tennessee-garage/tasty-totems/README.md

# tasty-totems
Repo for a zoetrope type of art project
