tennessee-garage/tasty-totems/pcb/tasty-totem-board-mux/tasty-totem-board.kicad_pcb

## KiCad design pcb/tasty-totem-board-mux/tasty-totem-board.kicad_pcb (2024-07-24)

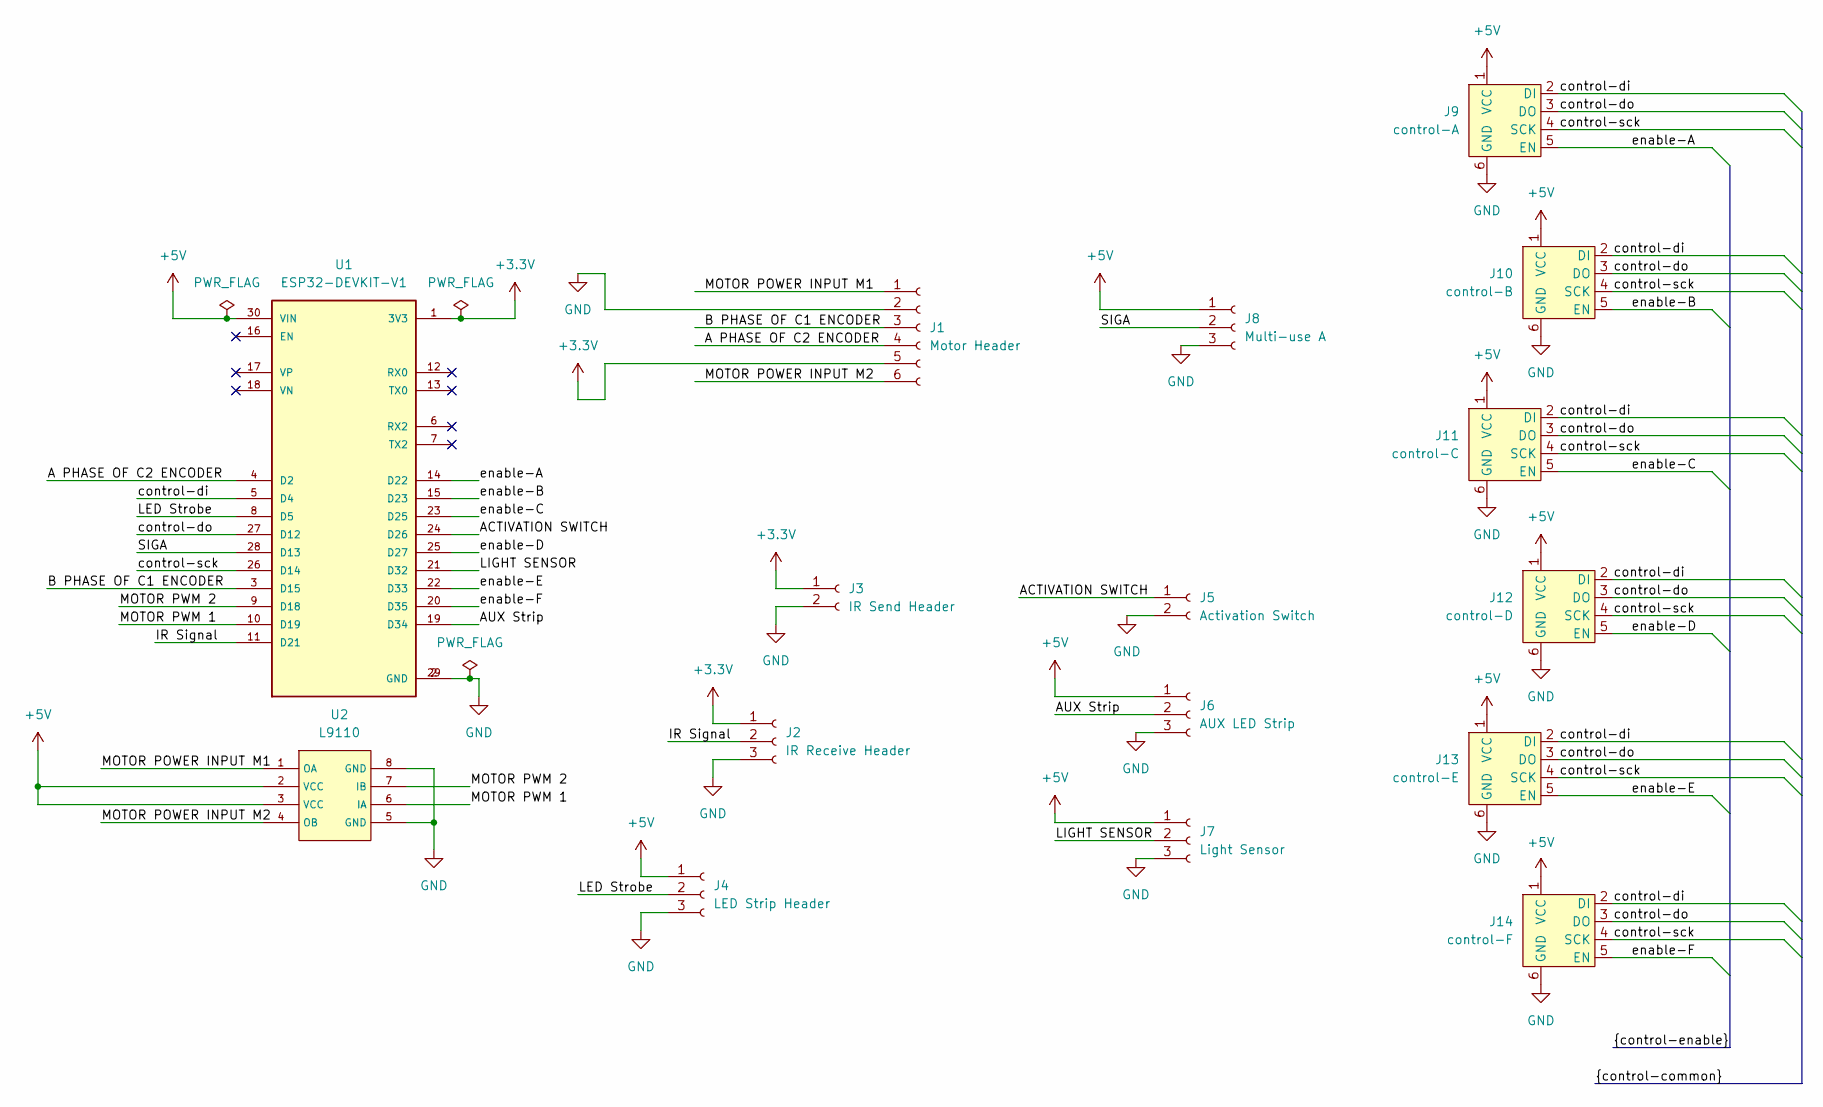
[picture p1: schematic tasty-totem-board.kicad_sch, Main Board]

Parts:
J1: Motor Header; PinSocket_1x06_P2.54mm_Horizontal
J2: IR Receive Header; PinSocket_1x03_P2.54mm_Horizontal
J3: IR Send Header; PinSocket_1x02_P2.54mm_Horizontal
J4: LED Strip Header; PinSocket_1x03_P2.54mm_Horizontal
J5: Activation Switch; PinSocket_1x02_P2.54mm_Horizontal
J6: AUX LED Strip; PinSocket_1x03_P2.54mm_Horizontal
J7: Light Sensor; PinSocket_1x03_P2.54mm_Horizontal
J8: Multi-use A; PinSocket_1x03_P2.54mm_Horizontal
J9: control-A; RJ11-RA
J10: control-B; RJ11-RA
J11: control-C; RJ11-RA
J12: control-D; RJ11-RA
J13: control-E; RJ11-RA
J14: control-F; RJ11-RA
U1: ESP32-DEVKIT-V1; MODULE_ESP32_DEVKIT_V1; PARTREV N/A
U2: L9110; DIP-8_W7.62mm

Connections:
+3.3V: J1.5, J2.1, J3.1, U1.1 (3V3)
+5V: J4.1, J6.1, J7.1, J8.1, J9.1 (VCC), J10.1 (VCC), J11.1 (VCC), J12.1 (VCC), J13.1 (VCC), J14.1 (VCC), U1.30 (VIN), U2.2 (VCC), U2.3 (VCC)
/A PHASE OF C2 ENCODER: J1.4, U1.4 (D2)
/ACTIVATION SWITCH: J5.1, U1.24 (D26)
/AUX Strip: J6.2, U1.19 (D34)
/B PHASE OF C1 ENCODER: J1.3, U1.3 (D15)
/IR Signal: J2.2, U1.11 (D21)
/LED Strobe: J4.2, U1.8 (D5)
/LIGHT SENSOR: J7.2, U1.21 (D32)
/MOTOR POWER INPUT M1: J1.1, U2.1 (OA)
/MOTOR POWER INPUT M2: J1.6, U2.4 (OB)
/MOTOR PWM 1: U1.10 (D19), U2.6 (IA)
/MOTOR PWM 2: U1.9 (D18), U2.7 (IB)
/SIGA: J8.2, U1.28 (D13)
/control-di: J9.2 (DI), J10.2 (DI), J11.2 (DI), J12.2 (DI), J13.2 (DI), J14.2 (DI), U1.5 (D4)
/control-do: J9.3 (DO), J10.3 (DO), J11.3 (DO), J12.3 (DO), J13.3 (DO), J14.3 (DO), U1.27 (D12)
/control-sck: J9.4 (SCK), J10.4 (SCK), J11.4 (SCK), J12.4 (SCK), J13.4 (SCK), J14.4 (SCK), U1.26 (D14)
/enable-A: J9.5 (EN), U1.14 (D22)
/enable-B: J10.5 (EN), U1.15 (D23)
/enable-C: J11.5 (EN), U1.23 (D25)
/enable-D: J12.5 (EN), U1.25 (D27)
/enable-E: J13.5 (EN), U1.22 (D33)
/enable-F: J14.5 (EN), U1.20 (D35)
GND: J1.2, J2.3, J3.2, J4.3, J5.2, J6.3, J7.3, J8.3, J9.6 (GND), J10.6 (GND), J11.6 (GND), J12.6 (GND), J13.6 (GND), J14.6 (GND), U1.2 (GND), U1.29 (GND), U2.5 (GND), U2.8 (GND)

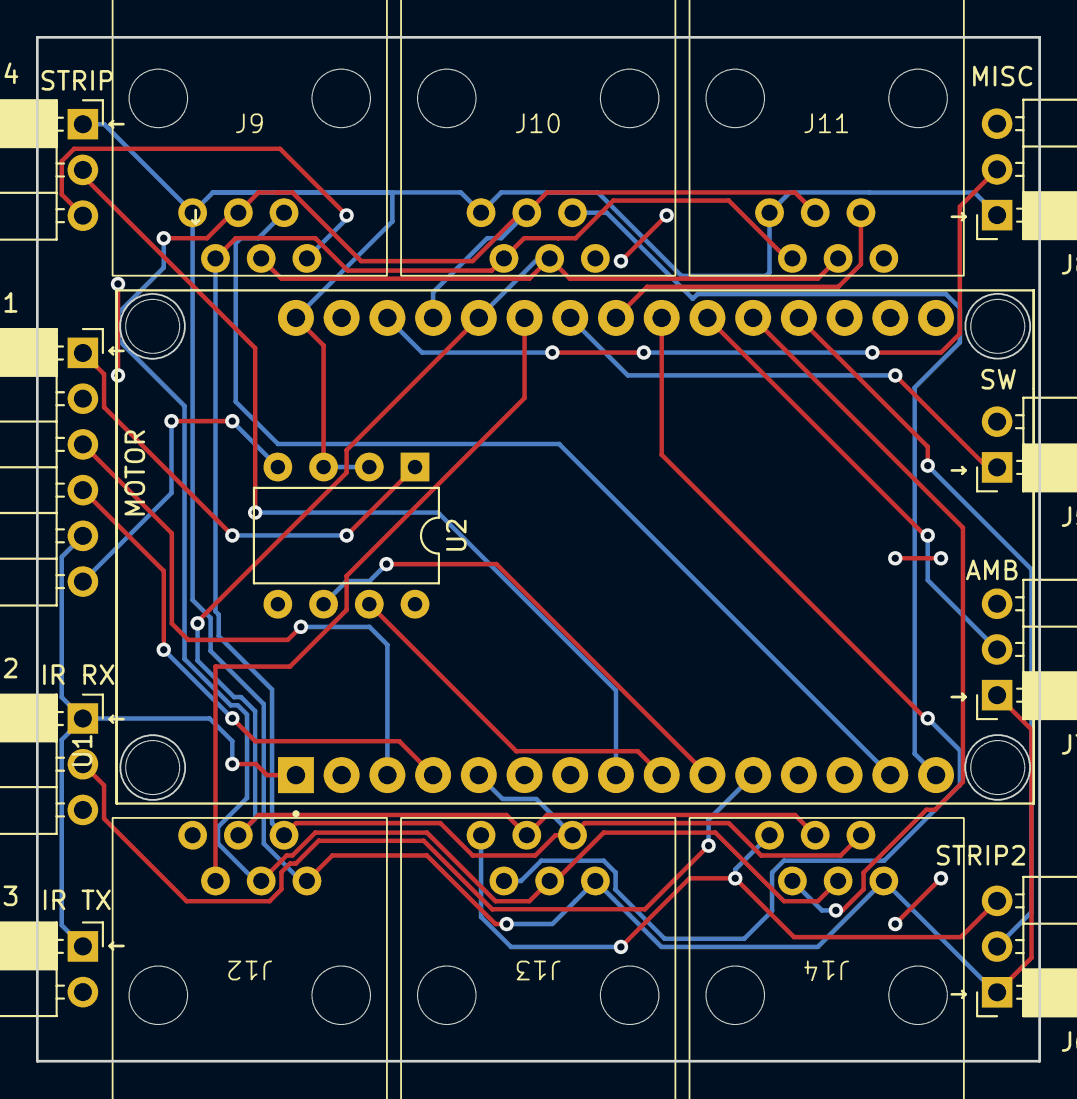
[picture p2: board tasty-totem-board.kicad_pcb from above]

Board: 2 copper layers, 55.7 x 56.9 mm, 16 parts (0 on the bottom side), 24 nets.
