tennessee-garage/tasty-totems/pcb/7-segment-driver/7-segment-driver.kicad_pcb

## KiCad design pcb/7-segment-driver/7-segment-driver.kicad_pcb (2024-07-24)

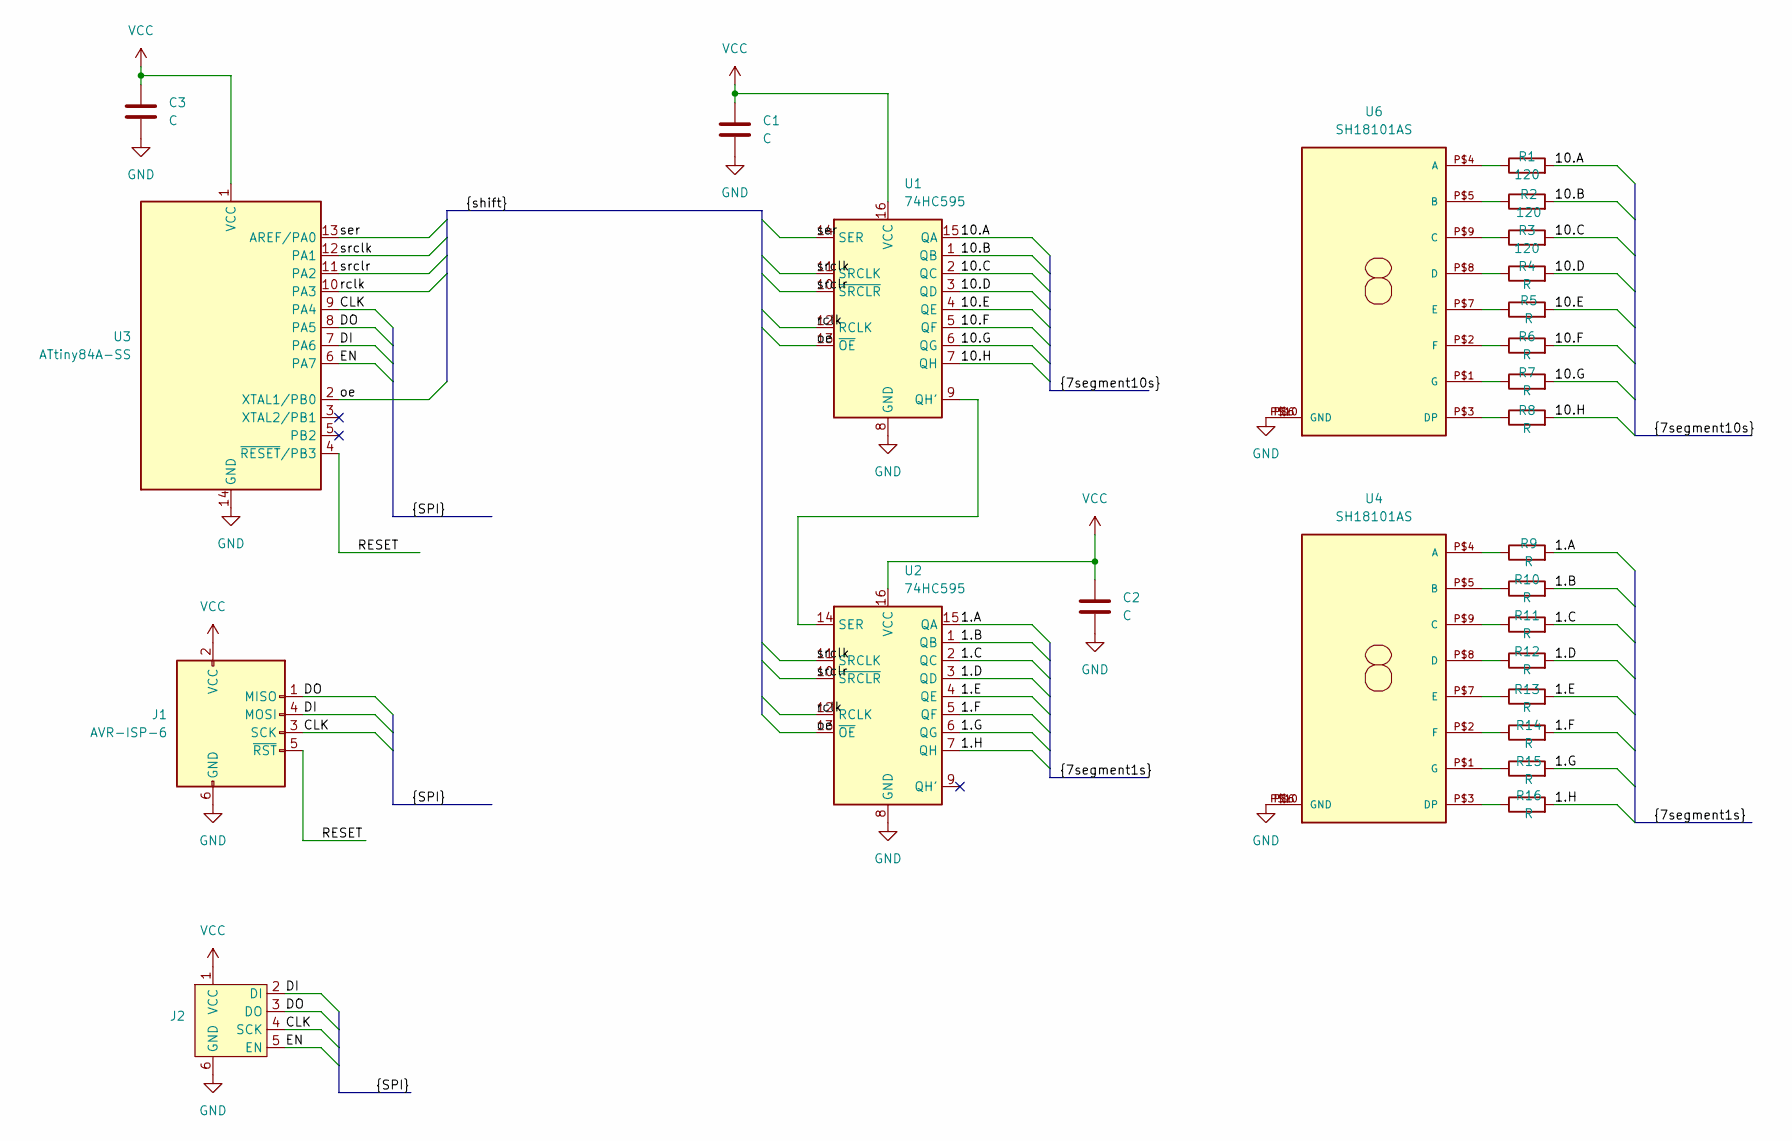
[picture p3: schematic 7-segment-driver.kicad_sch]

Parts:
C1, C2, C3: C; C_0805_2012Metric
J1: AVR-ISP-6; IDC-Header_2x03_P2.54mm_Vertical
J2: RJ11-Straight
R1, R2, R3: 120; R_0805_2012Metric_Pad1.20x1.40mm_HandSolder
R4, R5, R6, R7, R8, R9, R10, R11, R12, R13, R14, R15, R16: R; R_0805_2012Metric_Pad1.20x1.40mm_HandSolder
U1, U2: 74HC595; TSSOP-16_4.4x5mm_P0.65mm
U3: ATtiny84A-SS; SOIC-14_3.9x8.7mm_P1.27mm
U4, U6: SH18101AS

Connections:
/1.A: R9.2, U2.15 (QA)
/1.B: R10.2, U2.1 (QB)
/1.C: R11.2, U2.2 (QC)
/1.D: R12.2, U2.3 (QD)
/1.E: R13.2, U2.4 (QE)
/1.F: R14.2, U2.5 (QF)
/1.G: R15.2, U2.6 (QG)
/1.H: R16.2, U2.7 (QH)
/10.A: R1.2, U1.15 (QA)
/10.B: R2.2, U1.1 (QB)
/10.C: R3.2, U1.2 (QC)
/10.D: R4.2, U1.3 (QD)
/10.E: R5.2, U1.4 (QE)
/10.F: R6.2, U1.5 (QF)
/10.G: R7.2, U1.6 (QG)
/10.H: R8.2, U1.7 (QH)
/CLK: J1.3 (SCK), J2.4 (SCK), U3.9 (PA4)
/DI: J1.4 (MOSI), J2.2 (DI), U3.7 (PA6)
/DO: J1.1 (MISO), J2.3 (DO), U3.8 (PA5)
/EN: J2.5 (EN), U3.6 (PA7)
/RESET: J1.5 (~RST), U3.4 (~RESET/PB3)
/oe: U1.13 (~OE), U2.13 (~OE), U3.2 (XTAL1/PB0)
/rclk: U1.12 (RCLK), U2.12 (RCLK), U3.10 (PA3)
/ser: U1.14 (SER), U3.13 (AREF/PA0)
/srclk: U1.11 (SRCLK), U2.11 (SRCLK), U3.12 (PA1)
/srclr: U1.10 (~SRCLR), U2.10 (~SRCLR), U3.11 (PA2)
GND: C1.2, C2.2, C3.2, J1.6 (GND), J2.6 (GND), U1.8 (GND), U2.8 (GND), U3.14 (GND), U4.P$6 (GND), U4.P$10 (GND), U6.P$6 (GND), U6.P$10 (GND)
unnamed: U1.9 (QH'), U2.14 (SER)
unnamed: R9.1, U4.P$4 (A)
unnamed: R10.1, U4.P$5 (B)
unnamed: R11.1, U4.P$9 (C)
unnamed: R12.1, U4.P$8 (D)
unnamed: R16.1, U4.P$3 (DP)
unnamed: R13.1, U4.P$7 (E)
unnamed: R14.1, U4.P$2 (F)
unnamed: R15.1, U4.P$1 (G)
unnamed: R1.1, U6.P$4 (A)
unnamed: R2.1, U6.P$5 (B)
unnamed: R3.1, U6.P$9 (C)
unnamed: R4.1, U6.P$8 (D)
unnamed: R8.1, U6.P$3 (DP)
unnamed: R5.1, U6.P$7 (E)
unnamed: R6.1, U6.P$2 (F)
unnamed: R7.1, U6.P$1 (G)
VCC: C1.1, C2.1, C3.1, J1.2 (VCC), J2.1 (VCC), U1.16 (VCC), U2.16 (VCC), U3.1 (VCC)

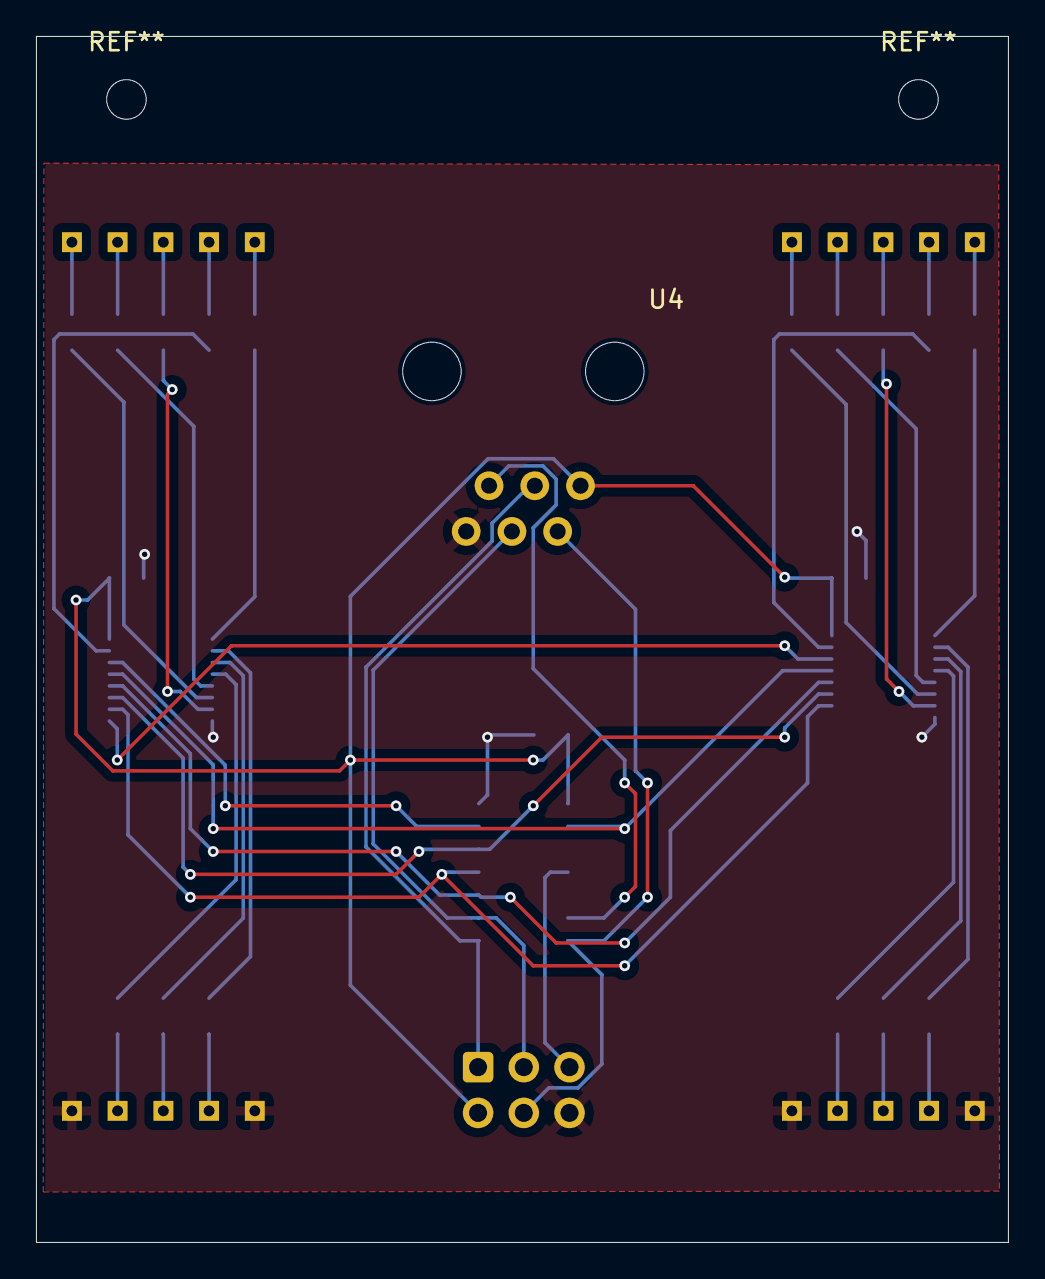
[picture p4: board 7-segment-driver.kicad_pcb from above]

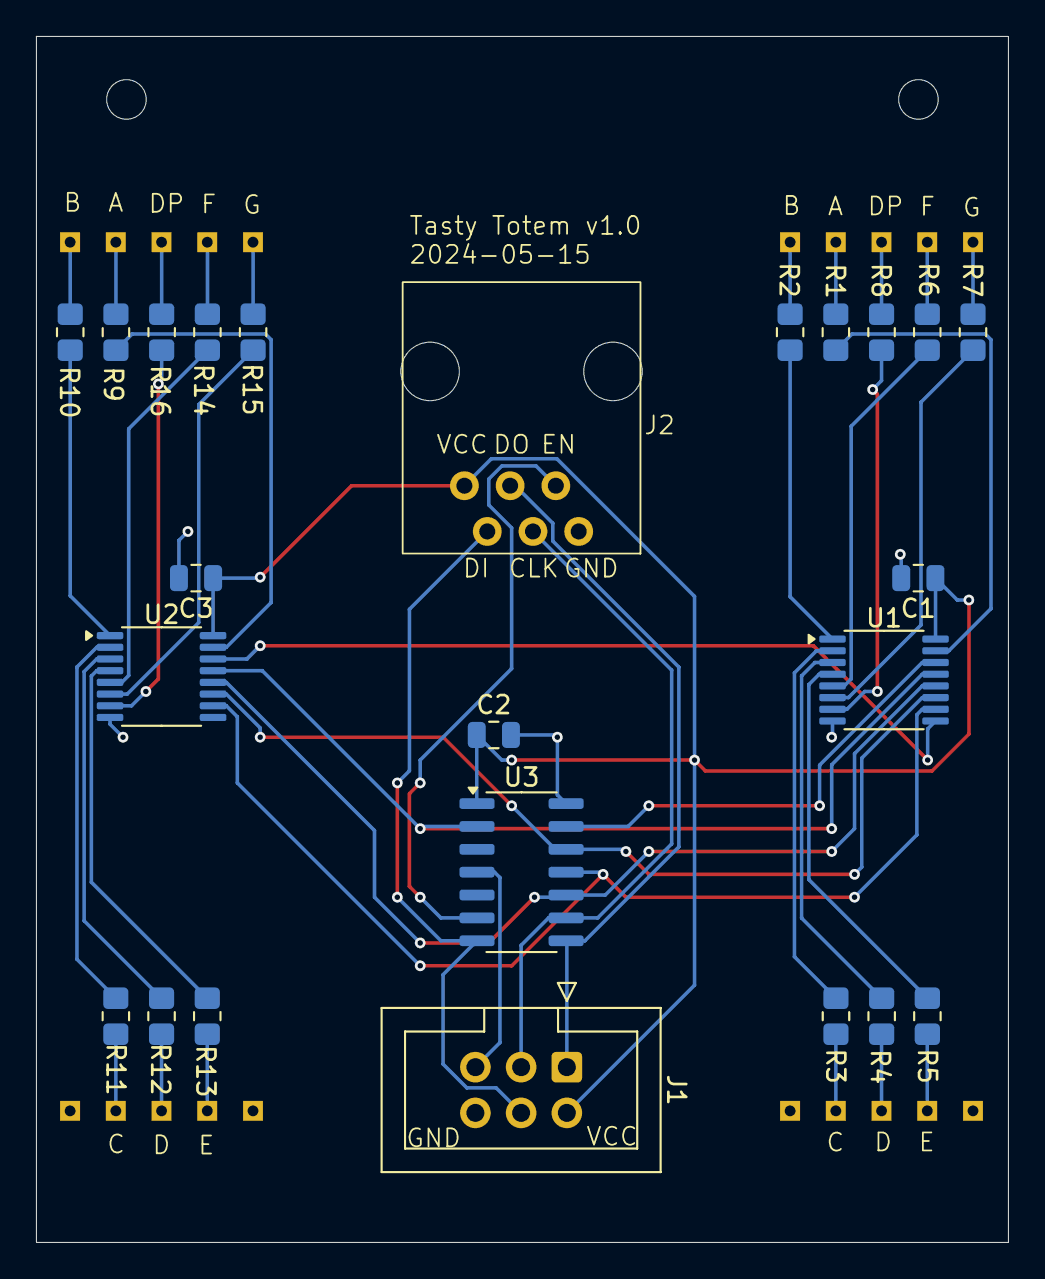
[picture p5: board 7-segment-driver.kicad_pcb from below]

Board: 2 copper layers, 54.0 x 67.0 mm, 26 parts (24 on the bottom side), 45 nets.
