tennessee-garage/tasty-totems/pcb/vu-meter/vu-meter.kicad_pcb

## KiCad design pcb/vu-meter/vu-meter.kicad_pcb (2024-07-24)

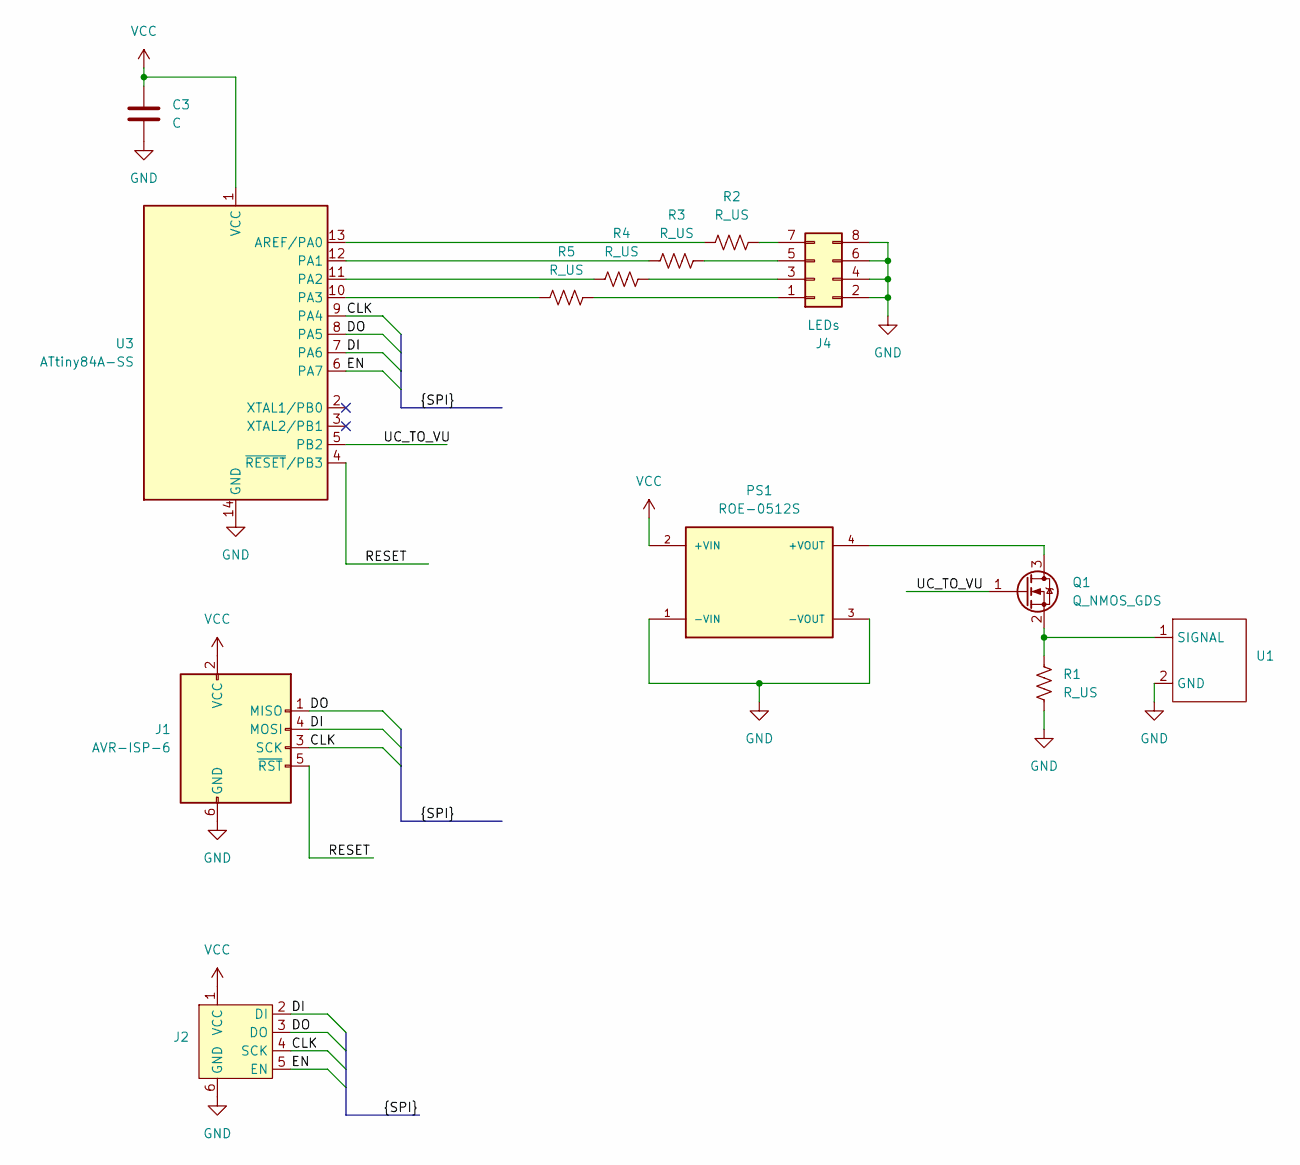
[picture p6: schematic vu-meter.kicad_sch]

Parts:
C3: C; C_0805_2012Metric
J1: AVR-ISP-6; IDC-Header_2x03_P2.54mm_Vertical
J2: RJ11-Straight
J4: LEDs; PinHeader_2x04_P2.54mm_Vertical
PS1: ROE-0512S; CONV_ROE-0512S; PARTREV 5
Q1: Q_NMOS_GDS; SOT-323_SC-70_Handsoldering
R1, R2, R3, R4, R5: R_US; R_0805_2012Metric_Pad1.20x1.40mm_HandSolder
U1: VU-Meter
U3: ATtiny84A-SS; SOIC-14_3.9x8.7mm_P1.27mm

Connections:
/CLK: J1.3 (SCK), J2.4 (SCK), U3.9 (PA4)
/DI: J1.4 (MOSI), J2.2 (DI), U3.7 (PA6)
/DO: J1.1 (MISO), J2.3 (DO), U3.8 (PA5)
/EN: J2.5 (EN), U3.6 (PA7)
/RESET: J1.5 (~RST), U3.4 (~RESET/PB3)
/UC_TO_VU: Q1.1 (G), U3.5 (PB2)
GND: C3.2, J1.6 (GND), J2.6 (GND), J4.2, J4.4, J4.6, J4.8, PS1.1 (-VIN), PS1.3 (-VOUT), R1.2, U1.2 (GND), U3.14 (GND)
unnamed: J4.1, R5.2
unnamed: J4.3, R4.2
unnamed: J4.5, R3.2
unnamed: J4.7, R2.2
unnamed: PS1.4 (+VOUT), Q1.3 (D)
unnamed: Q1.2 (S), R1.1, U1.1 (SIGNAL)
unnamed: R2.1, U3.13 (AREF/PA0)
unnamed: R3.1, U3.12 (PA1)
unnamed: R4.1, U3.11 (PA2)
unnamed: R5.1, U3.10 (PA3)
VCC: C3.1, J1.2 (VCC), J2.1 (VCC), PS1.2 (+VIN), U3.1 (VCC)

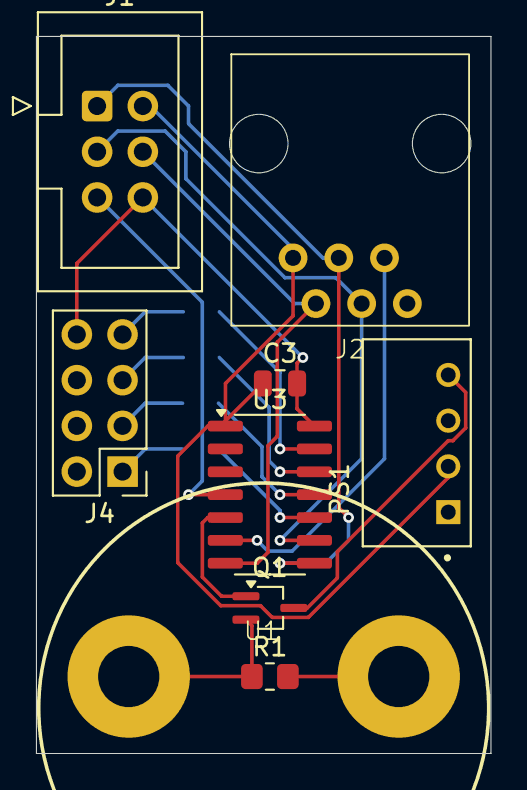
[picture p7: board vu-meter.kicad_pcb from above]

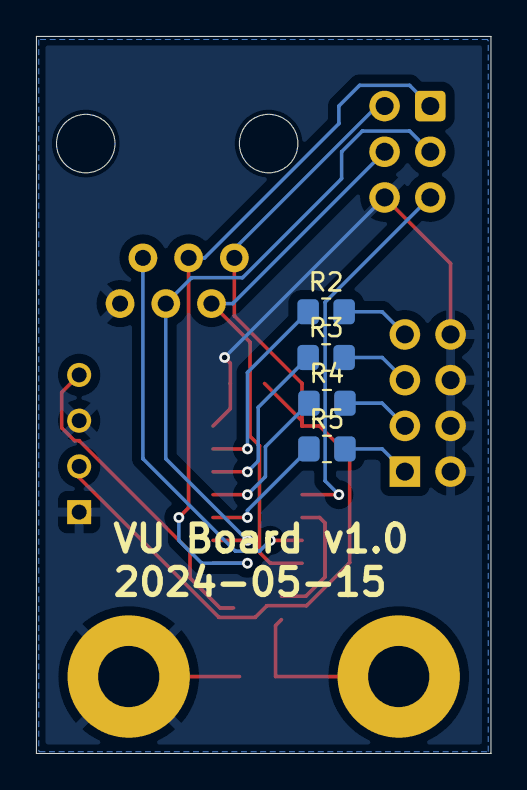
[picture p8: board vu-meter.kicad_pcb from below]

Board: 2 copper layers, 25.3 x 39.8 mm, 13 parts (4 on the bottom side), 18 nets.
