tennessee-garage/tasty-totems/pcb/rotary-control/rotary-control.kicad_pcb

## KiCad design pcb/rotary-control/rotary-control.kicad_pcb (2024-07-24)

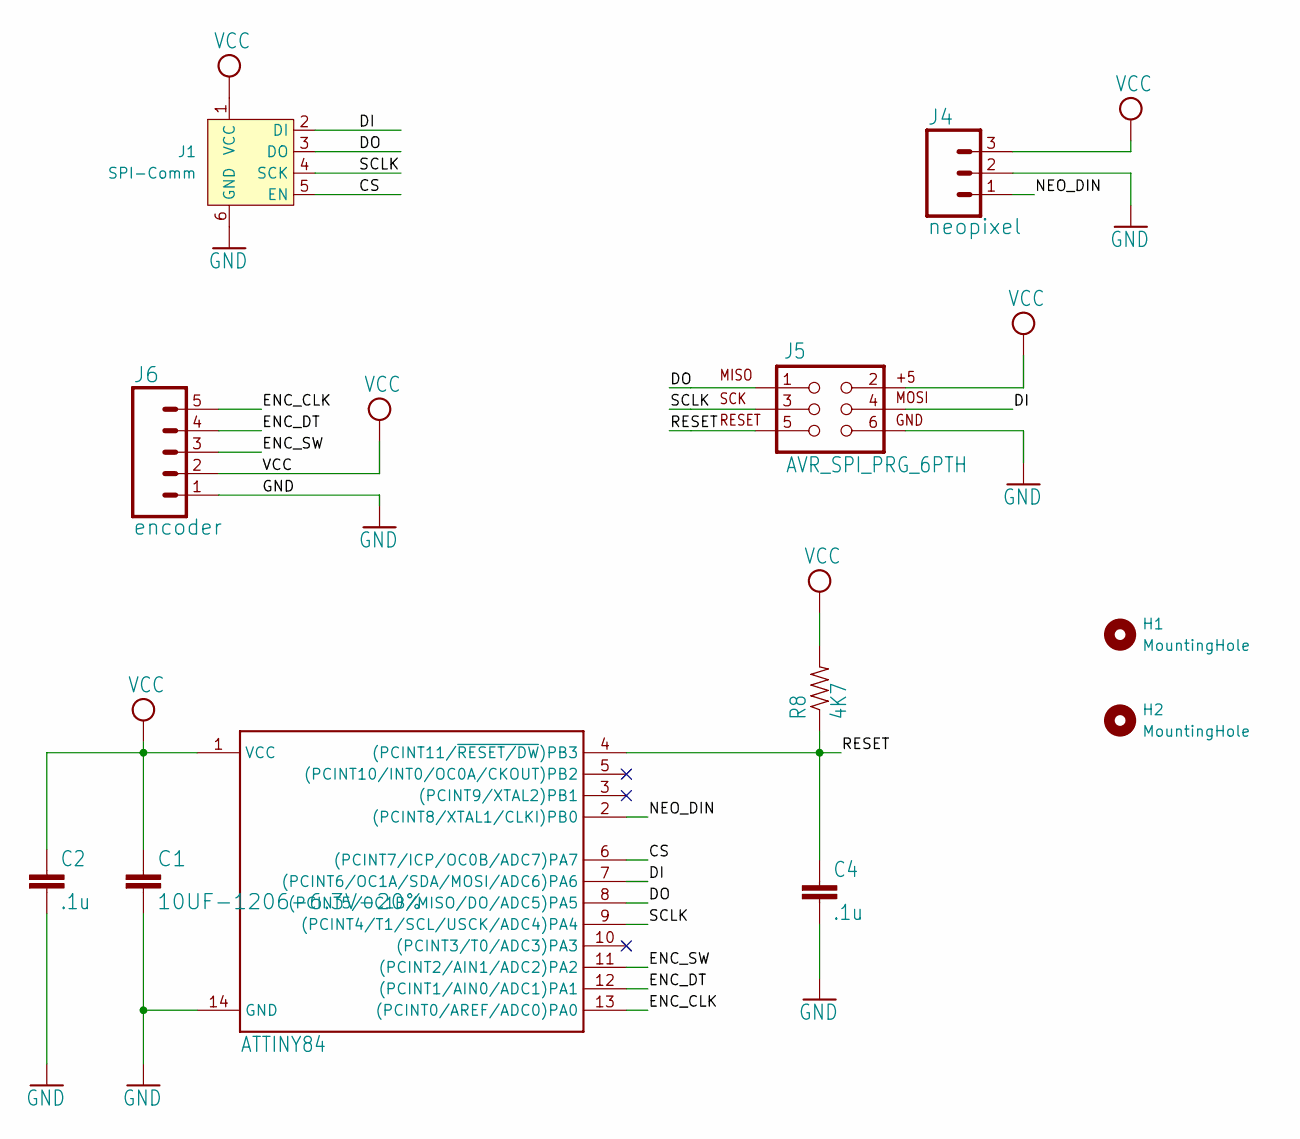
[picture p9: schematic rotary-control.kicad_sch]

Parts:
C1: 10UF-1206-6.3V-20%; C_1206_3216Metric_Pad1.33x1.80mm_HandSolder
C2, C4: .1u; 0805
H1, H2: MountingHole; MountingHole_2.7mm_M2.5_Pad
J1: SPI-Comm; RJ11-Straight
J4: neopixel; PinHeader_1x03_P2.54mm_Vertical
J5: AVR_SPI_PRG_6PTH; 2X3
J6: encoder; PinHeader_1x05_P2.54mm_Vertical
R8: 4K7; 0805
U$2: ATTINY84; SOIC-14_3.9x8.7mm_P1.27mm

Connections:
/CS: J1.5 (EN), U$2.6 ((PCINT7/ICP/OC0B/ADC7)PA7)
/DI: J1.2 (DI), J5.4, U$2.7 ((PCINT6/OC1A/SDA/MOSI/ADC6)PA6)
/DO: J1.3 (DO), J5.1, U$2.8 ((PCINT5/OC1B/MISO/DO/ADC5)PA5)
/ENC_CLK: J6.5, U$2.13 ((PCINT0/AREF/ADC0)PA0)
/ENC_DT: J6.4, U$2.12 ((PCINT1/AIN0/ADC1)PA1)
/ENC_SW: J6.3, U$2.11 ((PCINT2/AIN1/ADC2)PA2)
/NEO_DIN: J4.1, U$2.2 ((PCINT8/XTAL1/CLKI)PB0)
/RESET: C4.1, J5.5, R8.1, U$2.4 ((PCINT11/~RESET/DW)PB3)
/SCLK: J1.4 (SCK), J5.3, U$2.9 ((PCINT4/T1/SCL/USCK/ADC4)PA4)
GND: C1.2, C2.2, C4.2, J1.6 (GND), J4.2, J5.6, J6.1, U$2.14 (GND)
VCC: C1.1, C2.1, J1.1 (VCC), J4.3, J5.2, J6.2, R8.2, U$2.1 (VCC)

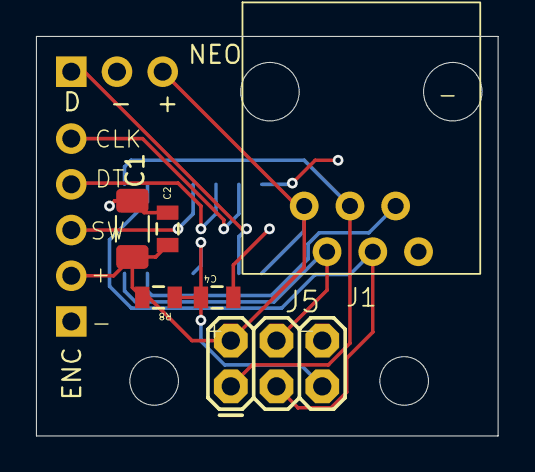
[picture p10: board rotary-control.kicad_pcb from above]

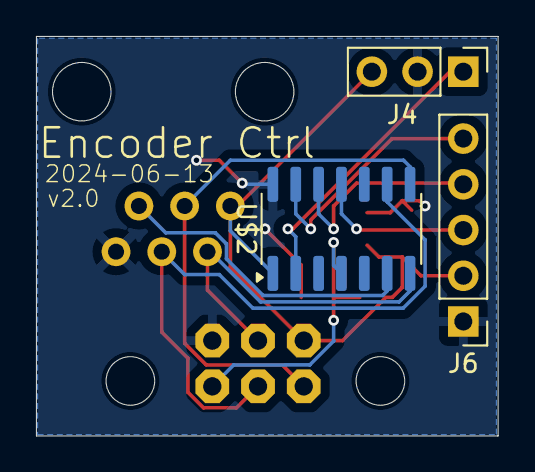
[picture p11: board rotary-control.kicad_pcb from below]

Board: 2 copper layers, 25.6 x 22.2 mm, 11 parts (3 on the bottom side), 11 nets.
