tennessee-garage/tasty-totems/(commit log)

2023-07-16 Uploaded new version of driver code, art and pcb files
    Driver code now broken out into classes.
    PCB files are incomplete but bookmarking here to get the new structure in git
    [tasty-totem-board.kicad_pcb, tasty-totem-board.kicad_sch]
2024-04-13 Separate out code to a greater extent
    * Move relavent constants out to specific handler classes
    * Create an encoder class
    * Create a rotation (IR) handler class
    * New main header for constants, to help sharing with other test files
    * Reduce the amount of code in the main tasty-totems.cpp
2024-04-13 Add ability to change the pwm frequency via analog input
2024-04-13 Generated gerber files
    [tasty-totem-board-B_Cu.gbr, tasty-totem-board-B_Mask.gbr, tasty-totem-board-B_Paste.gbr, tasty-totem-board-B_Silkscreen.gbr, tasty-totem-board-Edge_Cuts.gbr, tasty-totem-board-F_Cu.gbr, tasty-totem-board-F_Mask.gbr, tasty-totem-board-F_Paste.gbr]
2024-04-13 Checkpoint current version of PCB design files
    [tasty-totem-board.kicad_pcb, tasty-totem-board.kicad_sch]
2024-04-17 Got PID controller to a working state with reasonable constants
2024-04-17 New PID control class to encapsulate the PID logic.
    Intention is to pull existing PID code out of the MotorControl class
2024-04-17 Updated all classes/code to use new PID Contoller
    Also
    * flipped motor pins to make clockwise the default direction
    * moved PID constants out to main class
    * shifted around some constants to more appropriate places
    [tasty-totems.cpp, tasty-totems.h, test-motor-frequency.cpp]
2024-04-25 Several changes that make this current iteration a good v1.0. These include * tuning the PID a bit * adding a DrumMonitor class to manage the frames, rotations and other details about the animations 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
2024-05-22 Comitting all prior updates to the board before wiring in SPI ports
    [tasty-totem-board.kicad_sch]
2024-05-24 Check in imoprted (from eagle) rotary-control
    [rotary-control.kicad_pcb, rotary-control.kicad_sch]
2024-05-24 An ignore file for kicad stuff
2024-05-24 Checkin boards that have been designed and already sent out
    [7-segment-driver.kicad_pcb, 7-segment-driver.kicad_sch, vu-meter.kicad_pcb, vu-meter.kicad_sch]
2024-07-24 Checkpoint PCB files.
    [7-segment-driver.kicad_pcb, 7-segment-driver.kicad_sch, rotary-control.kicad_pcb, rotary-control.kicad_sch, tasty-totem-board.kicad_pcb, tasty-totem-board.kicad_sch, testing.kicad_pcb, testing.kicad_sch]
